CarlosCiconato/ecu-master/README.md

# ECU placa: hardware da injeção programável (base rusEFI)

> **Procurando o programa de ajuste (Mac/Windows)?** Ele fica em [CarlosCiconato/ecu-app](https://github.com/CarlosCiconato/ecu-app), com os instaladores em [Releases](https://github.com/CarlosCiconato/ecu-app/releases). Aqui fica só a placa.

Placa da ECU: placa KiCad, caixa 3D, firmware da placa e manuais.

| Pasta | O que tem |
|---|---|
| [`01-Firmware-rusEFI`](01-Firmware-rusEFI) | Configuração da placa no rusEFI e os patches de todas as melhorias |
| [`02-Placas-PCB`](02-Placas-PCB) | Placa top 6c completa (KiCad): esquema, placa e caixa 3D |
| [`03-Manuais-e-notas`](03-Manuais-e-notas) | Notas da placa, resumo das funções e como continuar o projeto |
| Programa | Está no repositório [ecu-app](https://github.com/CarlosCiconato/ecu-app) |

## Firmware

- Base: rusEFI oficial, commit `1b0196058f6`, com as nossas melhorias em patches.
- Código do rusEFI: baixe em **https://github.com/rusefi/rusefi** e volte para o commit base:
  ```bash
  git clone https://github.com/rusefi/rusefi.git
  cd rusefi
  git checkout 1b0196058f6
  # depois aplique os patches de 01-Firmware-rusEFI/patches com git am, na ordem dos itens
  ```
  A ordem dos itens e os detalhes estão em `03-Manuais-e-notas/CONTINUAR.md`.
- Resumo da placa: [`placa-top6c-firmware.md`](01-Firmware-rusEFI/placa-top6c-firmware.md).

## Continuar o projeto

Veja [`03-Manuais-e-notas/CONTINUAR.md`](03-Manuais-e-notas/CONTINUAR.md) e [`LEIA-ME.md`](LEIA-ME.md).
