CarlosCiconato/ecu-master/02-Placas-PCB/top-6c-rascunho7/bom-jlc-top6c-r7.csv

Comment | Designator | Footprint | LCSC
Battery_Cell | BT1 | BatteryHolder_Keystone_1060_1x2032 | C238069
100n | C1,C10,C11,C12,C13,C14,C15,C16,C2,C2313,C2314,C2315,C2316,C2505,C2506,C2507,C2508,C2601,C2602,C2605,C2608,C2612,C2613,C2614,C2615,C2617,C2618,C2701,C2702,C2705,C2708,C2712,C2713,C2714,C2715,C2717,C2718,C3,C4,C5,C6,C7,C8,C9 | C_0402_1005Metric | C1525
1u | C1002,C1015,C1016,C1017,C1018,C1212,C1523,C2001,C2101 | C_0603_1608Metric | C15849
10u | C1004,C1201,C2010,C2110,C27,C906 | C_1206_3216Metric | C13585
4.7u | C1006,C1502,C1506,C1507,C1512,C1515,C2616,C2716,C30,C903 | C_0603_1608Metric | C19666
100n | C1101,C1211,C1409,C1501,C1503,C1504,C1505,C1508,C1509,C1510,C1511,C1513,C1516,C1517,C1520,C1604,C1607,C1701,C1704,C20,C2301,C2309,C2501,C701,C801,C901,C904 | C_0603_1608Metric | C14663
10n | C1202,C1203,C1301,C1302,C1303,C1304,C1605,C1606,C1608,C1609,C1702,C1703,C1705,C1706,C1903,C28,C29,C902 | C_0603_1608Metric | C57112
1n | C1204,C1205,C1207,C1208,C1209,C1210,C1401,C1402,C1403,C1404,C1405,C1406,C1407,C1408,C3101 | C_0603_1608Metric | C1588
2.2u | C1518,C1519 | C_0603_1608Metric | C23630
33p | C1521,C1522 | C_0402_1005Metric | C1562
3.3n | C1901,C1902 | C_0805_2012Metric | C53175
22u | C2006,C2106 | C_0805_2012Metric | C45783
680p | C21,C22 | C_0603_1608Metric | C1630
330p | C23,C24,C905 | C_0402_1005Metric | C13533
47p | C25,C26 | C_0402_1005Metric | C1567
1u | C2600,C2607,C2609,C2610,C2611,C2700,C2707,C2709,C2710,C2711 | C_0402_1005Metric | C52923
33n | C2603,C2703 | C_0402_1005Metric | C1585
1uF | C3601,C4004 | C_0603_1608Metric | C15849
10nF | C3602 | C_0603_1608Metric | C57112
470pF | C3603 | C_0603_1608Metric | C1620
100nF | C3604,C4003,C4007,C4008,C4009 | C_0603_1608Metric | C14663
10uF | C4001 | C_0805_2012Metric | C15850
22uF | C4002 | C_0805_2012Metric | C45783
18pF | C4005,C4006 | C_0603_1608Metric | C1647
PESD1CAN-UX | D1,D2 | SOT-323_SC-70 | C152727
SM15T33CA | D1001 | D_SMC | C151281
D_Schottky | D101,D102,D103,D104,D901,D903 | D_SMA | C8678
SRV05-4 | D1501,U1,U1106,U1107,U2,U2304,U2502,U3,U4 | SOT-23-6 | C85364
schottky | D1503,D3,D4 | D_SOD-123 | C8598
D_Schottky | D2002,D2102 | D_SMA | C22452
LED-RED-0603 | D2600,D2603,D2700,D2703 | LED_0603_1608Metric | C2286
LED-GREEN-0603 | D2601,D2701 | LED_0603_1608Metric | C72043
LED-BLUE-0603 | D2602,D2702 | LED_0603_1608Metric | C72041
PESD1CAN | D2604,D2704 | SOT-23 | C343993
Polyfuse | F101,F102 | R_1206_3216Metric | C207035
Ferrite_Bead | FB1501 | L_0805_2012Metric | C1015
Micro_SD_Card | J1 | microSD_HC_Wuerth_693072010801 | C164170
USB-C HRO TYPE-C-31-M-12 | J3701 | USB_C_Receptacle_HRO_TYPE-C-31-M-12 | C165948
10u | L1001 | MWSA0503 | C408412
2.2u | L1002 | L_1210_3225Metric | C3222669
VNN7NV04PTR-E | Q2600,Q2700 | SOT-223 | C501115
AO3401A | Q3001,Q3011,Q3021 | SOT-23 | C15127
2N7002 | Q3002,Q3012,Q3022 | SOT-23 | C8545
5.6k | R1,R10,R11,R12,R17,R18,R19,R2,R20,R2325,R2326,R2327,R2328,R25,R2509,R2510,R2511,R2512,R26,R27,R28,R3,R4,R9 | R_0402_1005Metric | C25908
10k | R1001,R1006,R1007,R1105,R1107,R1109,R1111,R13,R14,R15,R1502,R1504,R1513,R16,R21,R22,R23,R2329,R2330,R2331,R2332,R24,R2513,R2514,R2515,R2516,R2604,R2605,R2613,R2614,R2618,R2619,R2625,R2704,R2705,R2713,R2714,R2718,R2719,R2725,R29,R30,R31,R32,R48,R5,R6,R7,R8,R905 | R_0402_1005Metric | C25744
120 | R1004,R1106,R1108,R1110,R1112,R33 | R_0603_1608Metric | C22787
2.7k | R1101,R1102,R1103,R1104,R1201,R1202,R1203,R1204,R1401,R1402,R1403,R1404,R1405,R1406,R1407,R1408,R2301,R2302,R2303,R2304 | R_0603_1608Metric | C13167
4.7k | R1205,R1206,R1208,R1209,R1210,R1211,R1213,R1214,R1215,R1216,R3101,R3102,R3103,R3104,R3106,R34,R35,R36,R37 | R_0805_2012Metric | C17673
1k | R1217,R1218,R2600,R2601,R2616,R2617,R2622,R2626,R2627,R2628,R2700,R2701,R2716,R2717,R2722,R2726,R2727,R2728,R39,R41 | R_0402_1005Metric | C11702
100k | R1501,R1901,R1902,R2615,R2621,R2715,R2721,R44,R45 | R_0402_1005Metric | C25741
82k | R1503 | R_0603_1608Metric | C23254
100 | R1601,R1602,R1603,R1604,R1701,R1702,R1703,R1704 | R_0805_2012Metric | C17408
470k | R1903,R1904,R2501,R2502,R2503,R2504,R701,R702,R703,R704,R801,R802,R803,R804,R901,R902,R903,R904 | R_0402_1005Metric | C25790
68k | R2602,R2603,R2702,R2703,R908 | R_0402_1005Metric | C36871
10 | R2606,R2706 | R_0402_1005Metric | C25077
22k | R2607,R2707 | R_0402_1005Metric | C25768
47 | R2608,R2708 | R_0402_1005Metric | C25118
61.9 | R2609,R2709 | R_0603_1608Metric | C23092
20k | R2610,R2611,R2612,R2710,R2711,R2712 | R_0402_1005Metric | C25765
27k | R2620,R2623,R2720,R2723 | R_0402_1005Metric | C25771
3.3k | R2624,R2724 | R_0402_1005Metric | C25890
10k | R3001,R3011,R3021 | R_0805_2012Metric | C17414
1k | R3002,R3012,R3022,R3601 | R_0805_2012Metric | C17513
100k | R3003,R3013,R3023 | R_0805_2012Metric | C149504
5.1k | R3701,R3702 | R_0603_1608Metric | C23186
33k | R38,R40,R46,R47 | R_0402_1005Metric | C25779
10k | R4001,R4002 | R_0603_1608Metric | C25804
470 | R4003,R4004 | R_0603_1608Metric | C23179
0 | R4005,R4006 | R_0603_1608Metric | C21189
12k | R42,R43,R907 | R_0402_1005Metric | C25752
1 | R906 | R_0402_1005Metric | C25086
10k | RN1101,RN1301,RN2301,RN2501,RN701,RN801,RN901 | R_Array_Convex_4x0603 | C29718
1k | RN1601,RN1701,RN201,RN202,RN2201,RN2202,RN301,RN302,RN401,RN402,RN501,RN502 | R_Array_Convex_4x0603 | C20197
SW_Push | SW1501,SW1502 | SW_SPST_EVQQ2 | C6039444
TLE9201SG | U10,U11 | Infineon_PG-DSO-12-9 | C112633
TLS115 | U1004,U1005 | Infineon_PG-DSO-8-43 | C3747428
MCP6004 | U1101,U2301,U2501,U2600,U2700,U5,U701,U801,U901 | TSSOP-14_4.4x5mm_P0.65mm | C50282
BTS4175SGA | U1102,U1103,U1104,U1105 | SOIC-8_3.9x4.9mm_P1.27mm | C152451
SN74LVC2G17DB | U1202,U1207,U1208 | SOT-23-6 | C10429
MAX9924 | U1203,U1204,U3101 | MSOP-10_3x3mm_P0.5mm | C143633
STM32F767IITx | U1501 | LQFP-176_24x24mm_P0.5mm | C90234
USBLC6-2SC6 | U1502 | SOT-23-6 | C7519
MIC4427 | U1602,U1603,U1701,U1702 | SOIC-8_3.9x4.9mm_P1.27mm | C20551
VNLD5160 | U201,U202,U2201,U2202,U301,U302,U401,U402,U501,U502 | SOIC-8_3.9x4.9mm_P1.27mm | C377942
AD8628 | U2601,U2701 | TSOT-23-5 | C29309
STM32F042K6Tx | U2602,U2702 | LQFP-32_7x7mm_P0.8mm | C69216
REF3033 | U2603,U2703 | SOT-23 | C36658
XC6206P332MR | U2604,U2704 | SOT-23 | C5446
TJA1051T/3/1J | U2605,U2705 | SO-8_3.9x4.9mm_P1.27mm | C38695
ESP32-S3-WROOM-1U-N8 | U4001 | ESP32-S3-WROOM-1U | C2980297
AMS1117-3.3 | U4002,U902 | SOT-223-3_TabPin2 | C6186
TJA1051T-3 | U6,U904 | SOIC-8_3.9x4.9mm_P1.27mm | C38695
MCP6002-xSN | U7 | SOIC-8_3.9x4.9mm_P1.27mm | C7377
REF3333 | U8 | SOT-23 | C130016
LPS25HB | U9 | ST_HLGA-10_2.5x2.5mm_P0.6mm_LayoutBorder3x2y | C87898
LMR14020 | U903 | SOIC-8-1EP_3.9x4.9mm_P1.27mm_EP2.29x3mm | C187824
8MHz | Y1501 | Crystal_SMD_5032-2Pin_5.0x3.2mm | C115962
32.768kHz 12.5pF | Y4001 | Crystal_SMD_3215-2Pin_3.2x1.5mm | C32346
