CarlosCiconato/ecu-master/02-Placas-PCB/caixa-3d-placa-top6c/placa-fantasma.stl

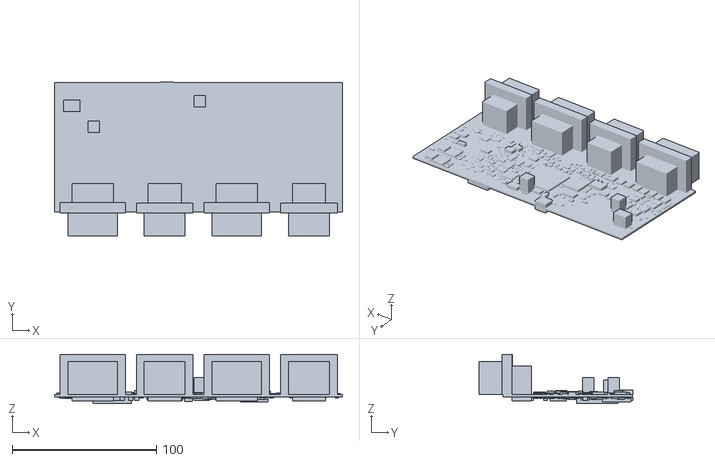
[picture p1: CAD file, 2026-11-10]
02-Placas-PCB/caixa-3d-placa-top6c/placa-fantasma.stl
200.0 x 106.8 x 34.1
