CarlosCiconato/ecu-master/02-Placas-PCB/caixa-3d-placa-top6c/base.stl

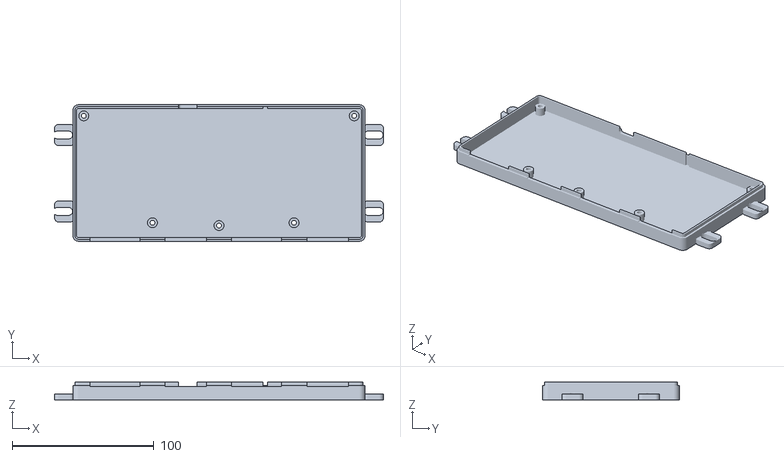
[picture p2: CAD file, 2026-11-10]
02-Placas-PCB/caixa-3d-placa-top6c/base.stl
232.4 x 96.5 x 12.5
