CarlosCiconato/ecu-master/02-Placas-PCB/caixa-3d-placa-top6c/v1-reta/tampa.stl

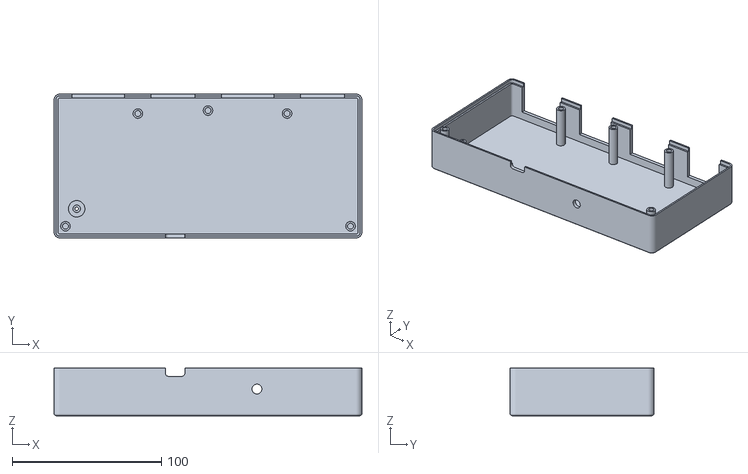
[picture p3: CAD file, 2026-11-10]
02-Placas-PCB/caixa-3d-placa-top6c/v1-reta/tampa.stl
206.4 x 96.5 x 31.9
