CarlosCiconato/ecu-master/02-Placas-PCB/caixa-3d-placa-top6c/caixa.step

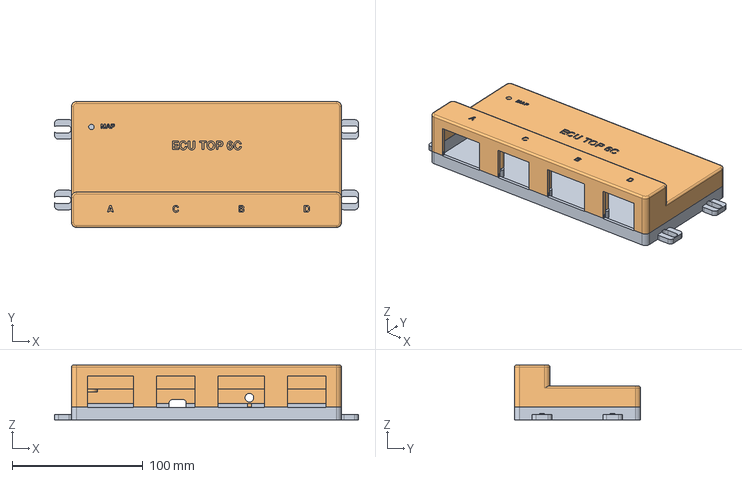
[picture p4: CAD file, 2026-11-10]
02-Placas-PCB/caixa-3d-placa-top6c/caixa.step
232.4 x 96.5 x 41.9 mm
base
tampa
