CarlosCiconato/ecu-master/02-Placas-PCB/caixa-3d-placa-top6c/v1-reta/caixa.step

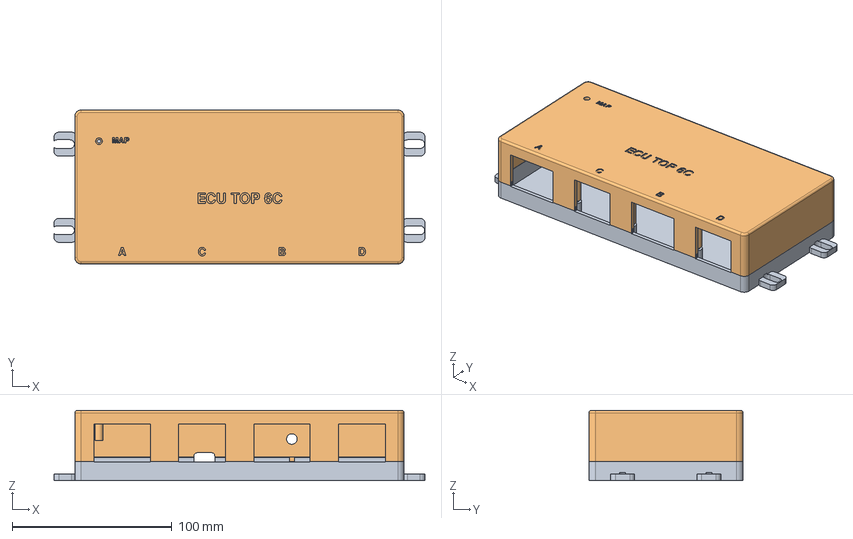
[picture p5: CAD file, 2026-11-10]
02-Placas-PCB/caixa-3d-placa-top6c/v1-reta/caixa.step
232.4 x 96.5 x 43.9 mm
base
tampa
