CarlosCiconato/ecu-master/02-Placas-PCB/caixa-3d-placa-top6c/v1-reta/base.stl

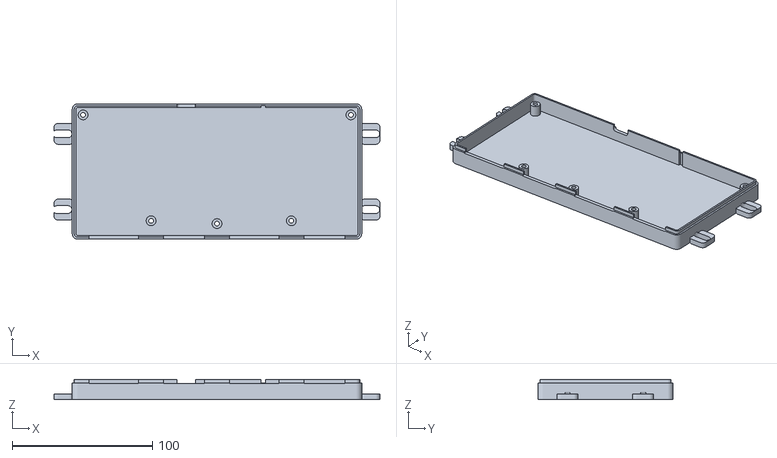
[picture p6: CAD file, 2026-11-10]
02-Placas-PCB/caixa-3d-placa-top6c/v1-reta/base.stl
232.4 x 96.5 x 14.5
