CarlosCiconato/ecu-master/02-Placas-PCB/caixa-3d-placa-top6c/tampa.stl

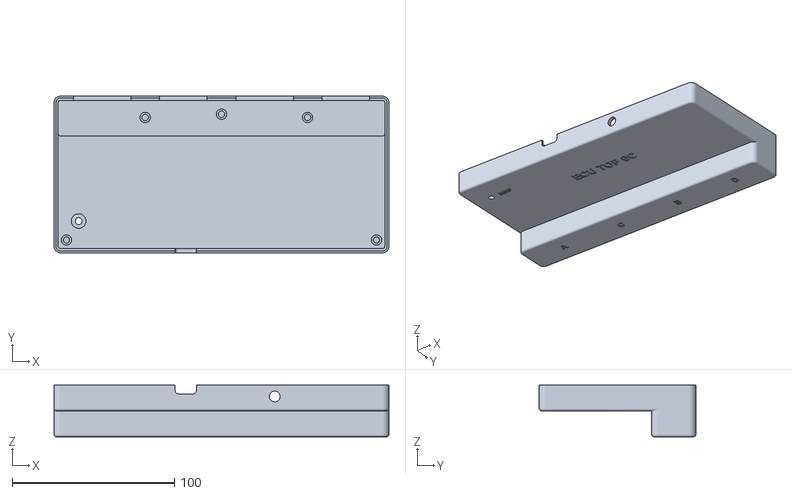
[picture p7: CAD file, 2026-11-10]
02-Placas-PCB/caixa-3d-placa-top6c/tampa.stl
206.4 x 96.5 x 31.9
