CarlosCiconato/ecu-master/02-Placas-PCB/top-6c-esquema-kicad/proteus.kicad_pcb

## KiCad design 02-Placas-PCB/top-6c-esquema-kicad/proteus.kicad_pcb (2026-11-10)

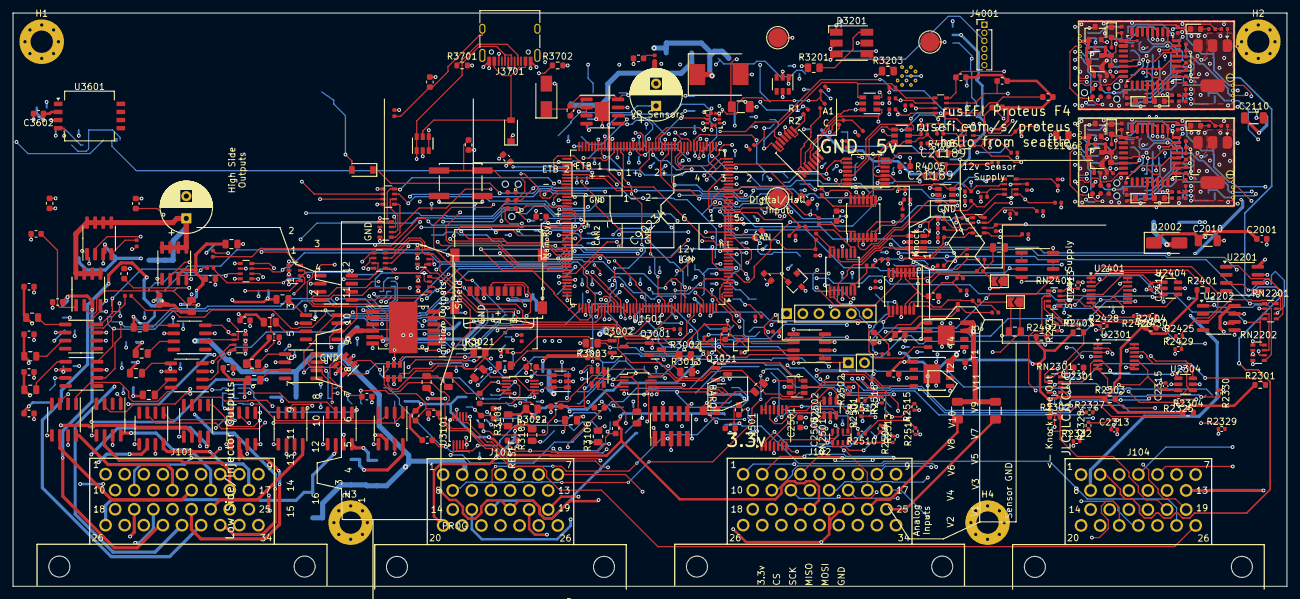
[picture p8: board proteus.kicad_pcb from above]

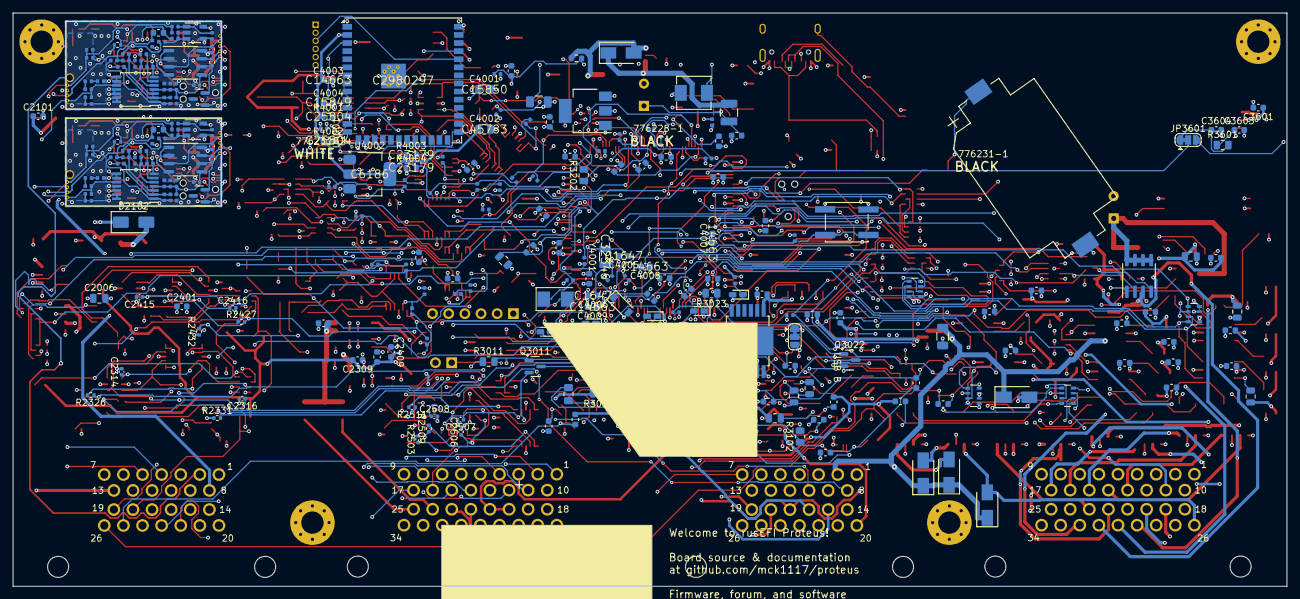
[picture p9: board proteus.kicad_pcb from below]

Board: 6 copper layers, 200.0 x 90.0 mm, 613 parts (252 on the bottom side), 481 nets.

Parts:
BT1: Battery_Cell; BatteryHolder_Keystone_1060_1x2032
C1, C2, C3, C4, C5, C6, C7, C8, C9, C10, C11, C12, C13, C14, C15, C16, C2313, C2314, C2315, C2316, C2413, C2414, C2415, C2416, C2505, C2506, C2507, C2508, C2601, C2602, C2605, C2608, C2612, C2613, C2614, C2615, C2617, C2618, C2701, C2702, C2705, C2708, C2712, C2713, C2714, C2715, C2717, C2718: 100n; C_0402_1005Metric
C17, C1001: 56u; CP_Radial_D8.0mm_P3.50mm
C20, C701, C801, C901, C904, C1101, C1211, C1409, C1501, C1503, C1504, C1505, C1508, C1509, C1510, C1511, C1513, C1516, C1517, C1520, C1604, C1607, C1701, C1704, C1801, C1804, C2301, C2309, C2401, C2409, C2501: 100n; C_0603_1608Metric
C21, C22: 680p; C_0603_1608Metric
C23, C24, C905: 330p; C_0402_1005Metric
C25, C26: 47p; C_0402_1005Metric
C27, C906, C1004, C1201, C2010, C2110: 10u; C_1206_3216Metric
C28, C29, C902, C1202, C1203, C1301, C1302, C1303, C1304, C1605, C1606, C1608, C1609, C1702, C1703, C1705, C1706, C1802, C1803, C1805, C1806, C1903: 10n; C_0603_1608Metric
C30, C903, C1006, C1502, C1506, C1507, C1512, C1515, C2616, C2716: 4.7u; C_0603_1608Metric
C1002, C1015, C1016, C1017, C1018, C1212, C1523, C2001, C2101: 1u; C_0603_1608Metric
C1204, C1205, C1207, C1208, C1209, C1210, C1401, C1402, C1403, C1404, C1405, C1406, C1407, C1408, C3101: 1n; C_0603_1608Metric
C1518, C1519: 2.2u; C_0603_1608Metric
C1521, C1522: 33p; C_0402_1005Metric
C1901, C1902: 3.3n; C_0805_2012Metric
C2006, C2106: 22u; C_0805_2012Metric
C2600, C2607, C2609, C2610, C2611, C2700, C2707, C2709, C2710, C2711: 1u; C_0402_1005Metric
C2603, C2703: 33n; C_0402_1005Metric
C2604, C2606, C2704, C2706: DNP; C_0402_1005Metric
C3601, C4004: 1uF; C_0603_1608Metric
C3602: 10nF; C_0603_1608Metric
C3603: 470pF; C_0603_1608Metric
C3604, C4003, C4007, C4008, C4009: 100nF; C_0603_1608Metric
C4001: 10uF; C_0805_2012Metric
C4002: 22uF; C_0805_2012Metric
C4005, C4006: 18pF; C_0603_1608Metric
D1, D2: PESD1CAN-UX; SOT-323_SC-70
D3, D4, D1503: schottky; D_SOD-123
D101, D102, D103, D104, D901, D903, D2002, D2102: D_Schottky; D_SMA
D1001: SM15T33CA; D_SMC
D1501: SRV05-4; SOT-23-6
D1502, D1506: GREEN; LED_0603_1608Metric_Castellated
D1504: RED; LED_0603_1608Metric_Castellated
D1505: BLUE; LED_0603_1608Metric_Castellated
D1507: ORANGE; LED_0603_1608Metric_Castellated
D2600, D2603, D2700, D2703: LED-RED-0603; LED_0603_1608Metric
D2601, D2701: LED-GREEN-0603; LED_0603_1608Metric
D2602, D2702: LED-BLUE-0603; LED_0603_1608Metric
D2604, D2704: PESD1CAN; SOT-23
D3201: LED RGB; LED_RGB_5050-6
F101, F102: Polyfuse; R_1206_3216Metric
FB1501: Ferrite_Bead; L_0805_2012Metric
H1, H2, H3, H4: MountingHole_3.5mm_Pad_Via
J1: Micro_SD_Card; microSD_HC_Wuerth_693072010801
J2: Conn_01x02; PinHeader_1x02_P2.54mm_Vertical
J4: Conn_01x06; Tag-Connect_TC2030-IDC-NL_2x03_P1.27mm_Vertical
J101: Superseal 1.0 34p · A motor (34); 6437288-2
J102: Superseal 1.0 34p · B sensores (34); 6437288-2
J103: Superseal 1.0 26p · C carro (26); 6473423-1
J104: Superseal 1.0 26p · D sondas/extras (26); 6473423-1
J105, J107, J108: Conn_01x01; TestPoint_Pad_D3.0mm
J1502: Conn_02x05_Odd_Even; PinHeader_2x05_P1.27mm_Vertical_SMD
J1505: Conn_01x06; PinHeader_1x06_P2.54mm_Vertical
J2600, J2700: Conn_02x03_Odd_Even; Tag-Connect_TC2030-IDC-NL_2x03_P1.27mm_Vertical
J3701: USB-C HRO TYPE-C-31-M-12; USB_C_Receptacle_HRO_TYPE-C-31-M-12
J4001: PROG_ESP32; PinHeader_1x06_P1.27mm_Vertical
JP1, JP2: Jumper_NO_Small; SolderJumper-2_P1.3mm_Open_TrianglePad1.0x1.5mm
JP1201: Jumper_3_Bridged12; SolderJumper-3_P1.3mm_Bridged12_RoundedPad1.0x1.5mm
JP3601: MAP int(1-2)/ext(2-3); SolderJumper-3_P1.3mm_Bridged12_RoundedPad1.0x1.5mm
L1001: 10u; MWSA0503
L1002: 2.2u; L_1210_3225Metric
M1, M2: Module-wbo-0.6; wbo
Q2600, Q2700: VNN7NV04PTR-E; SOT-223
Q3001, Q3011, Q3021: AO3401A; SOT-23
Q3002, Q3012, Q3022: 2N7002; SOT-23
R1, R2, R3, R4, R9, R10, R11, R12, R17, R18, R19, R20, R25, R26, R27, R28, R2325, R2326, R2327, R2328, R2425, R2426, R2427, R2428, R2509, R2510, R2511, R2512: 5.6k; R_0402_1005Metric
R5, R6, R7, R8, R13, R14, R15, R16, R21, R22, R23, R24, R29, R30, R31, R32, R48, R905, R1001, R1006, R1007, R1105, R1107, R1109, R1111, R1502, R1504, R1513, R2329, R2330, R2331, R2332, R2429, R2430, R2431, R2432, R2513, R2514, R2515, R2516, R2604, R2605, R2613, R2614, R2618, R2619, R2625, R2704, R2705, R2713, R2714, R2718, R2719, R2725: 10k; R_0402_1005Metric
R33, R1004, R1106, R1108, R1110, R1112: 120; R_0603_1608Metric
R34, R35, R36, R37, R1205, R1206, R1208, R1209, R1210, R1211, R1213, R1214, R1215, R1216, R3101, R3102, R3103, R3104, R3106: 4.7k; R_0805_2012Metric
R38, R40, R46, R47: 33k; R_0402_1005Metric
R39, R41, R1217, R1218, R2600, R2601, R2616, R2617, R2622, R2626, R2627, R2628, R2700, R2701, R2716, R2717, R2722, R2726, R2727, R2728: 1k; R_0402_1005Metric
R42, R43, R907: 12k; R_0402_1005Metric
R44, R45, R1501, R1901, R1902, R2615, R2621, R2715, R2721: 100k; R_0402_1005Metric
R701, R702, R703, R704, R801, R802, R803, R804, R901, R902, R903, R904, R1903, R1904, R2501, R2502, R2503, R2504: 470k; R_0402_1005Metric
R906: 1; R_0402_1005Metric
R908, R2602, R2603, R2702, R2703: 68k; R_0402_1005Metric
R1101, R1102, R1103, R1104, R1201, R1202, R1203, R1204, R1401, R1402, R1403, R1404, R1405, R1406, R1407, R1408, R2301, R2302, R2303, R2304, R2401, R2402, R2403, R2404: 2.7k; R_0603_1608Metric
R1207, R1212, R3105: DNP; R_0805_2012Metric
R1219, R1220: DNP; R_0805_2012Metric_Pad1.15x1.40mm_HandSolder
R1503: 82k; R_0603_1608Metric
R1508, R1509, R1510, R1511, R1512: 330; R_0402_1005Metric
R1601, R1602, R1603, R1604, R1701, R1702, R1703, R1704, R1801, R1802, R1803, R1804: 100; R_0805_2012Metric
R2606, R2706: 10; R_0402_1005Metric
R2607, R2707: 22k; R_0402_1005Metric
R2608, R2708: 47; R_0402_1005Metric
R2609, R2709: 61.9; R_0603_1608Metric
R2610, R2611, R2612, R2710, R2711, R2712: 20k; R_0402_1005Metric
R2620, R2623, R2720, R2723: 27k; R_0402_1005Metric
R2624, R2724: 3.3k; R_0402_1005Metric
R2629, R2630, R2729, R2730: DNP; R_0402_1005Metric
R3001, R3011, R3021: 10k; R_0805_2012Metric
R3002, R3012, R3022, R3601: 1k; R_0805_2012Metric
R3003, R3013, R3023: 100k; R_0805_2012Metric
R3201, R3202, R3203: 330; R_0805_2012Metric
R3701, R3702: 5.1k; R_0603_1608Metric
R4001, R4002: 10k; R_0603_1608Metric
R4003, R4004: 470; R_0603_1608Metric
R4005, R4006: 0; R_0603_1608Metric
RN201, RN202, RN301, RN302, RN401, RN402, RN501, RN502, RN1601, RN1701, RN1801, RN2201, RN2202: 1k; R_Array_Convex_4x0603
RN701, RN801, RN901, RN1101, RN1301, RN2301, RN2401, RN2501: 10k; R_Array_Convex_4x0603
SW1501, SW1502: SW_Push; SW_SPST_EVQQ2
U1, U2, U3, U4, U1106, U1107, U2304, U2404, U2502: SRV05-4; SOT-23-6
U5, U701, U801, U901, U1101, U2301, U2401, U2501, U2600, U2700: MCP6004; TSSOP-14_4.4x5mm_P0.65mm
U6, U904: TJA1051T-3; SOIC-8_3.9x4.9mm_P1.27mm
U7: MCP6002-xSN; SOIC-8_3.9x4.9mm_P1.27mm
U8: REF3333; SOT-23
U9: LPS25HB; ST_HLGA-10_2.5x2.5mm_P0.6mm_LayoutBorder3x2y
U10, U11: TLE9201SG; Infineon_PG-DSO-12-9
U201, U202, U301, U302, U401, U402, U501, U502, U2201, U2202: VNLD5160; SOIC-8_3.9x4.9mm_P1.27mm
U902, U4002: AMS1117-3.3; SOT-223-3_TabPin2
U903: LMR14020; SOIC-8-1EP_3.9x4.9mm_P1.27mm_EP2.29x3mm
U1004, U1005: TLS115; Infineon_PG-DSO-8-43
U1102, U1103, U1104, U1105: BTS4175SGA; SOIC-8_3.9x4.9mm_P1.27mm
U1202, U1207, U1208: SN74LVC2G17DB; SOT-23-6
U1203, U1204, U3101: MAX9924; MSOP-10_3x3mm_P0.5mm
U1501: STM32F767IITx; LQFP-176_24x24mm_P0.5mm
U1502: USBLC6-2SC6; SOT-23-6
U1602, U1603, U1701, U1702, U1801, U1802: MIC4427; SOIC-8_3.9x4.9mm_P1.27mm
U2601, U2701: AD8628; TSOT-23-5
U2602, U2702: STM32F042K6Tx; LQFP-32_7x7mm_P0.8mm
U2603, U2703: REF3033; SOT-23
U2604, U2704: XC6206P332MR; SOT-23
U2605, U2705: TJA1051T/3/1J; SO-8_3.9x4.9mm_P1.27mm
U3601: MPXH6400A (4 bar abs); Freescale_98ARH99066A
U4001: ESP32-S3-WROOM-1U-N8; ESP32-S3-WROOM-1U
Y1501: 8MHz; Crystal_SMD_5032-2Pin_5.0x3.2mm
Y4001: 32.768kHz 12.5pF; Crystal_SMD_3215-2Pin_3.2x1.5mm

Connections:
+3V3: C20.1, C903.1, C1503.2, C1504.2, C1505.2, C1506.2, C1507.2, C1508.2, C1509.2, C1510.2, C1511.2, C1512.2, C1513.2, C1515.2, C4007.1, C4008.1, C4009.1, D4.2, D1501.5, D1502.2, FB1501.1, J1.4, J4.1, J108.1, J1502.1, J1505.1, R39.1, R40.2, R41.1, R48.2, R1001.2, R1006.2, R1007.2, R1105.2, R1107.2, R1109.2, R1111.2, R1215.1, R1216.1, R1502.2, R3106.1, SW1502.2, U5.4, U6.5, U9.1, U9.6, U9.10, U10.2, U11.2, U902.2, U904.5, U1501.15, U1501.23, U1501.36, U1501.49, U1501.62, U1501.72, U1501.82, U1501.91, U1501.103, U1501.114, U1501.127, U1501.136, U1501.149, U1501.159, U1501.171, U1501.172
+5V: C701.1, C801.1, C901.1, C905.1, C906.1, C1004.1, C1101.1, C1211.1, C1604.2, C1607.2, C1701.2, C1704.2, C1801.2, C1804.2, C2006.1, C2106.1, C2301.1, C2401.1, C2501.1, C2610.1, C2613.1, C2617.1, C2710.1, C2713.1, C2717.1, C4001.1, D1503.1, J107.1, JP1201.1, L1001.2, M1.W1 (V5_IN), M2.W1 (V5_IN), Q3001.2, Q3011.2, Q3021.2, R908.2, R1217.1, R3001.1, R3011.1, R3021.1, U1.5, U2.5, U3.5, U4.5, U6.3, U7.8, U8.1, U701.4, U801.4, U901.4, U902.3, U904.3, U1004.5, U1005.5, U1101.4, U1106.5, U1107.5, U1202.5, U1203.9, U1203.10, U1204.10, U1207.5, U1208.5, U1602.6, U1603.6, U1701.6, U1702.6, U1801.6, U1802.6, U2301.4, U2304.5, U2401.4, U2404.5, U2501.4, U2502.5, U2603.1 (IN), U2604.3 (VI), U2605.3 (VCC), U2703.1 (IN), U2704.3 (VI), U2705.3 (VCC), U3101.10, U4002.3
/5V_SENSOR_1: C1016.1, C1409.2, C2309.2, C2409.2, J102.20, J102.21, R1101.1, R1102.1, R1103.1, R1104.1, R1201.1, R1203.1, R1401.1, R1403.1, R1405.1, R1407.1, R2301.1, R2302.1, R2303.1, R2304.1, R2401.1, R2402.1, R2403.1, R2404.1, U1004.1
/5V_SENSOR_2: C1018.1, C3601.1, C3602.1, J102.22, J102.23, U1005.1, U3601.2
/12V_MR: C17.1, C27.2, C1201.2, D101.1, D102.1, D103.1, D104.1, D2002.2, D2102.2, J103.2, U10.4, U11.4, U1102.5, U1102.6, U1102.7, U1102.8, U1103.5, U1103.6, U1103.7, U1103.8, U1104.5, U1104.6, U1104.7, U1104.8, U1105.5, U1105.6, U1105.7, U1105.8
/12V_PROT: C1015.1, C1017.1, D903.1, F101.2, F102.1, L1002.1, R906.1, U1004.7, U1004.8, U1005.7, U1005.8
/12V_RAW: D903.2, D1001.1, J103.1, R1503.1
/12V_SENS_1: F101.1, J102.24
/12V_SENS_2: F102.2, J102.25
/AIN13_PIN: J102.16, R2501.1, RN2501.1
/AIN14_EXT: J102.17, JP3601.3
/AIN14_PIN: JP3601.2, R2502.1, RN2501.2
/AT1: J102.12, R1101.2, RN1101.1
/AT2: J102.13, R1102.2, RN1101.2
/AT3: J102.14, R1103.2, RN1101.3
/AT4: J102.15, R1104.2, RN1101.4
/AV1: J102.1, R701.1, RN701.1
/AV2: J102.2, R702.1, RN701.2
/AV3: J102.3, R703.1, RN701.3
/AV4: J102.4, R704.1, RN701.4
/AV5: J102.5, R801.1, RN801.1
/AV6: J102.6, R802.1, RN801.2
/AV7: J102.7, R803.1, RN801.3
/AV8: J102.8, R804.1, RN801.4
/AV9: J102.9, R901.1, RN901.1
/AV10: J102.10, R902.1, RN901.2
/AV11: J102.11, R903.1, RN901.3
/CAN2+: D2.2, J103.9, R33.1, U6.7
/CAN2-: D2.1, J103.10, R33.2, U6.6
/CAN+: D1.2, D2604.1 (G), D2704.1 (G), J103.7, M1.W4 (CANH), M2.W4 (CANH), R1004.1, R2629.2, R2729.2, U904.7, U2605.7 (CANH), U2705.7 (CANH)
/CAN-: D1.1, D2604.2 (D), D2704.2 (D), J103.8, M1.W3 (CANL), M2.W3 (CANL), R1004.2, R2629.1, R2729.1, U904.6, U2605.6 (CANL), U2705.6 (CANL)
/DIGITAL_1: C1401.1, J103.21, R1401.2, R1402.2
/DIGITAL_2: C1403.1, J103.22, R1403.2, R1404.2
/DIGITAL_3: C1405.1, J103.23, R1405.2, R1406.2
/DIGITAL_4: C1407.1, J103.24, R1407.2, R1408.2
/DIGITAL_5: C1204.1, J104.25, R1201.2, R1202.2
/DIGITAL_6: C1207.1, J104.26, R1203.2, R1204.2
/ETB1+: C1202.2, J103.11, U10.5
/ETB1-: C1203.1, J103.12, U10.7
/ETB2+: C28.2, J103.13, U11.5
/ETB2-: C29.1, J103.14, U11.7
/HS1: C1301.1, J101.29, R34.1, U1102.3
/HS2: C1302.1, J101.30, R35.1, U1103.3
/HS3: C1303.1, J101.31, R36.1, U1104.3
/HS4: C1304.1, J101.32, R37.1, U1105.3
/IGN1: C1605.1, J101.1, R1601.1
/IGN2: C1606.1, J101.2, R1602.1
/IGN3: C1608.1, J101.3, R1603.1
/IGN4: C1609.1, J101.4, R1604.1
/IGN5: C1702.1, J101.5, R1701.1
/IGN6: C1703.1, J101.6, R1702.1
/IGN7: C1705.1, J101.7, R1703.1
/IGN8: C1706.1, J101.8, R1704.1
/IGN9: C1802.1, J101.9, R1801.1
/IGN10: C1803.1, J101.10, R1802.1
/IGN11: C1805.1, J101.11, R1803.1
/IGN12: C1806.1, J101.12, R1804.1
/KNOCK_1: C1901.2, J102.18, JP1.1
/KNOCK_2: C1902.2, J102.19, JP2.1
/LS1: J101.13, U201.8
/LS2: J101.14, U201.6
/LS3: J101.15, U202.8
/LS4: J101.16, U202.6
/LS5: J101.17, U301.8
/LS6: J101.18, U301.6
/LS7: J101.19, U302.8
/LS8: J101.20, U302.6
/LS9: J101.21, U401.8
/LS10: J101.22, U401.6
/LS11: J101.23, U402.8
/LS12: J101.24, U402.6
/LS13: D103.2, J101.25, U501.8
/LS14: D101.2, J101.26, U501.6
/LS15: D104.2, J101.27, U502.8
/LS16: D102.2, J101.28, U502.6
/LS17: J104.13, U2201.8
/LS18: J104.14, U2201.6
/LS19: J104.15, U2202.8
/LS20: J104.16, U2202.6
/SW1_PIN: J104.17, R2301.2, RN2301.1
/SW2_PIN: J104.18, R2302.2, RN2301.2
/SW3_PIN: J104.19, R2303.2, RN2301.3
/SW4_PIN: J104.20, R2304.2, RN2301.4
/SW5_PIN: J104.21, R2401.2, RN2401.1
/SW6_PIN: J104.22, R2402.2, RN2401.2
/SW7_PIN: J104.23, R2403.2, RN2401.3
/SW8_PIN: J104.24, R2404.2, RN2401.4
/VR1+: J103.15, R1205.2, R3002.2
/VR1-: J103.16, R1208.2
/VR2+: J103.17, R1210.2, R3012.2
/VR2-: J103.18, R1213.2
/VR3+: J103.19, R3022.2, R3101.2
/VR3-: J103.20, R3103.2
/WB1_HEATER+: C2001.1, C2010.1, D2002.1, J104.3
/WB1_HEATER-: J104.2, M1.E5 (LSU_Htr), Q2600.2 (D), Q2600.4 (D)
/WB1_IP: J104.1, M1.E3 (LSU_Ip), R2609.2, R2614.2
/WB1_RTRIM: J104.5, M1.E4 (LSU_Rtrim), R2605.1, R2608.1, R2609.1, R2613.2
/WB1_UN: C2605.1, J104.6, M1.E1 (LSU_Un), R2612.1, U2600.10 (+)
/WB1_VM: C2607.1, J104.4, M1.E2 (LSU_Vm), R2606.1, R2618.1, U2602.7 (PA1)
/WB2_HEATER+: C2101.1, C2110.1, D2102.1, J104.9
/WB2_HEATER-: J104.8, M2.E5 (LSU_Htr), Q2700.2 (D), Q2700.4 (D)
/WB2_IP: J104.7, M2.E3 (LSU_Ip), R2709.2, R2714.2
/WB2_RTRIM: J104.11, M2.E4 (LSU_Rtrim), R2705.1, R2708.1, R2709.1, R2713.2
/WB2_UN: C2705.1, J104.12, M2.E1 (LSU_Un), R2712.1, U2700.10 (+)
/WB2_VM: C2707.1, J104.10, M2.E2 (LSU_Vm), R2706.1, R2718.1, U2702.7 (PA1)
/WBO1/+3V3: C2601.1, C2602.1, C2604.1, C2606.1, C2614.1, C2615.1, C2616.1, C2618.1, J2600.1, M1.J_VCC1 (PULL_UP1), M1.J_VCC2 (PULL_UP2), M1.W2 (CAN_VIO), M1.W8 (V33_OUT), R2610.2, R2628.2, U2600.4 (V+), U2601.5 (V+), U2602.1 (VDD), U2602.17 (VDDIO2), U2604.2 (VO), U2605.5 (VIO)
/WBO1/Boot0: R2625.2, U2602.31 (PB8)
/WBO1/CAN_RX: U2602.21 (PA11), U2605.4 (RXD)
/WBO1/CAN_TX: U2602.22 (PA12), U2605.1 (TXD)
/WBO1/Ip_dac: R2602.1, U2602.12 (PA6)
/WBO1/Ip_sense: C2608.1, R2624.2, U2602.8 (PA2)
/WBO1/LED_BLUE: D2602.2 (A), U2602.28 (PB5)
/WBO1/LED_GREEN: D2601.2 (A), U2602.29 (PB6)
/WBO1/LSU_Un_sense: R2619.1, U2600.8, U2600.9 (-)
/WBO1/Nernst_esr_drive: R2607.2, U2602.30 (PB7)
/WBO1/Net-(C603-Pad1): C2603.1, R2604.1, R2608.2, U2600.1
/WBO1/Net-(C605-Pad2): C2605.2, R2607.1
/WBO1/Net-(D600-A): D2600.2 (A), R2616.1
/WBO1/Net-(D601-K): D2601.1 (K), R2626.2
/WBO1/Net-(D602-K): D2602.1 (K), R2627.2
/WBO1/Net-(D603-A): D2603.2 (A), R2628.1
/WBO1/Net-(M1-VDDA): M1.W9 (VDDA), R2630.2
/WBO1/Net-(Q600-G): Q2600.1 (G), R2622.1
/WBO1/Net-(R610-Pad1): R2610.1, R2611.2
/WBO1/Net-(R611-Pad1): R2611.1, R2612.2
/WBO1/Net-(R621-Pad1): R2621.1, R2624.1, U2601.1
/WBO1/Net-(U600A-+): R2603.1, R2605.2, U2600.3 (+)
/WBO1/Net-(U600A--): C2603.2, R2602.2, R2604.2, U2600.2 (-)
/WBO1/Net-(U600B-+): R2619.2, R2620.1, U2600.5 (+)
/WBO1/Net-(U600B--): R2618.2, R2623.1, U2600.6 (-)
/WBO1/Net-(U600D-+): C2600.1, R2600.2, R2601.1, U2600.12 (+)
/WBO1/Net-(U601-+): R2614.1, R2615.1, U2601.3 (+)
/WBO1/Net-(U601--): R2613.1, R2621.2, U2601.4 (-)
/WBO1/SEL1: M1.J1 (SEL1), U2602.15 (PB1)
/WBO1/SEL2: M1.J2 (SEL2), U2602.18 (PA8)
/WBO1/SWCLK: J2600.4, M1.W7 (SWCLK), U2602.24 (PA14)
/WBO1/SWDIO: J2600.2, M1.W6 (SWDIO), U2602.23 (PA13)
/WBO1/Un_sense: R2623.2, U2600.7, U2602.6 (PA0)
/WBO1/VDDA: C2611.1, C2612.1, R2600.1, R2630.1, U2602.5 (VDDA), U2603.2 (OUT)
/WBO1/Vm: R2603.2, R2606.2, R2615.2, U2600.13 (-), U2600.14, U2602.9 (PA3)
/WBO1/heater_pwm: R2616.2, R2617.2, R2622.2, U2602.13 (PA7)
/WBO1/nRESET: C2609.1, J2600.3, M1.W5 (nReset), U2602.4 (NRST)
/WBO2/+3V3: C2701.1, C2702.1, C2704.1, C2706.1, C2714.1, C2715.1, C2716.1, C2718.1, J2700.1, M2.J_VCC1 (PULL_UP1), M2.J_VCC2 (PULL_UP2), M2.W2 (CAN_VIO), M2.W8 (V33_OUT), R2710.2, R2728.2, U2700.4 (V+), U2701.5 (V+), U2702.1 (VDD), U2702.17 (VDDIO2), U2704.2 (VO), U2705.5 (VIO)
/WBO2/Boot0: R2725.2, U2702.31 (PB8)
/WBO2/CAN_RX: U2702.21 (PA11), U2705.4 (RXD)
/WBO2/CAN_TX: U2702.22 (PA12), U2705.1 (TXD)
/WBO2/Ip_dac: R2702.1, U2702.12 (PA6)
/WBO2/Ip_sense: C2708.1, R2724.2, U2702.8 (PA2)
/WBO2/LED_BLUE: D2702.2 (A), U2702.28 (PB5)
/WBO2/LED_GREEN: D2701.2 (A), U2702.29 (PB6)
/WBO2/LSU_Un_sense: R2719.1, U2700.8, U2700.9 (-)
/WBO2/Nernst_esr_drive: R2707.2, U2702.30 (PB7)
/WBO2/Net-(C603-Pad1): C2703.1, R2704.1, R2708.2, U2700.1
/WBO2/Net-(C605-Pad2): C2705.2, R2707.1
/WBO2/Net-(D600-A): D2700.2 (A), R2716.1
/WBO2/Net-(D601-K): D2701.1 (K), R2726.2
/WBO2/Net-(D602-K): D2702.1 (K), R2727.2
/WBO2/Net-(D603-A): D2703.2 (A), R2728.1
/WBO2/Net-(M1-VDDA): M2.W9 (VDDA), R2730.2
/WBO2/Net-(Q600-G): Q2700.1 (G), R2722.1
/WBO2/Net-(R610-Pad1): R2710.1, R2711.2
/WBO2/Net-(R611-Pad1): R2711.1, R2712.2
/WBO2/Net-(R621-Pad1): R2721.1, R2724.1, U2701.1
/WBO2/Net-(U600A-+): R2703.1, R2705.2, U2700.3 (+)
/WBO2/Net-(U600A--): C2703.2, R2702.2, R2704.2, U2700.2 (-)
/WBO2/Net-(U600B-+): R2719.2, R2720.1, U2700.5 (+)
/WBO2/Net-(U600B--): R2718.2, R2723.1, U2700.6 (-)
/WBO2/Net-(U600D-+): C2700.1, R2700.2, R2701.1, U2700.12 (+)
/WBO2/Net-(U601-+): R2714.1, R2715.1, U2701.3 (+)
/WBO2/Net-(U601--): R2713.1, R2721.2, U2701.4 (-)
/WBO2/SEL1: M2.J1 (SEL1), U2702.15 (PB1)
/WBO2/SEL2: M2.J2 (SEL2), U2702.18 (PA8)
/WBO2/SWCLK: J2700.4, M2.W7 (SWCLK), U2702.24 (PA14)
/WBO2/SWDIO: J2700.2, M2.W6 (SWDIO), U2702.23 (PA13)
/WBO2/Un_sense: R2723.2, U2700.7, U2702.6 (PA0)
/WBO2/VDDA: C2711.1, C2712.1, R2700.1, R2730.1, U2702.5 (VDDA), U2703.2 (OUT)
/WBO2/Vm: R2703.2, R2706.2, R2715.2, U2700.13 (-), U2700.14, U2702.9 (PA3)
/WBO2/heater_pwm: R2716.2, R2717.2, R2722.2, U2702.13 (PA7)
/WBO2/nRESET: C2709.1, J2700.3, M2.W5 (nReset), U2702.4 (NRST)
/analog5/IN3: R2503.1, RN2501.3
/analog5/IN4: R2504.1, RN2501.4
/analog5/OUT3: R2511.1, R2515.2
/analog5/OUT4: R2512.1, R2516.2
/knock/FILTERED_1: C23.2, U5.6, U5.7, U7.3, U1501.20
/knock/FILTERED_2: C24.2, U5.8, U5.9, U7.5, U1501.21
/knock/V_mid: C1903.2, R38.1, R40.1, U5.3, U5.12
/led_status/BA: D3201.4, R3203.2
/led_status/GA: D3201.5, R3202.2
/led_status/RA: D3201.6, R3201.2
/map_interno/MAPF: C3604.1, JP3601.1, R3601.2
/map_interno/VOUT: C3603.1, R3601.1, U3601.4
/mcu/5V_SENSOR_1_PG: R1006.1, U1004.4, U1501.43
/mcu/5V_SENSOR_2_PG: R1007.1, U1005.4, U1501.44
/mcu/12V_DIVIDED: C1523.1, D1501.1, R1503.2, R1504.1, U1501.53
/mcu/AT1: R25.1, R29.2, U1501.54
/mcu/AT2: R26.1, R30.2, U1501.55
/mcu/AT3: R27.1, R31.2, U1501.56
/mcu/AT4: R28.1, R32.2, U1501.57
/mcu/AUX_SPI_CS: J1505.2, U1501.24
/mcu/AUX_SPI_MISO: J1505.4, U1501.26
/mcu/AUX_SPI_MOSI: J1505.5, U1501.27
/mcu/AUX_SPI_SCK: J1505.3, U1501.25
/mcu/AV1: R1.1, R5.2, U1501.32
/mcu/AV2: R2.1, R6.2, U1501.33
/mcu/AV3: R3.1, R7.2, U1501.34
/mcu/AV4: R4.1, R8.2, U1501.35
/mcu/AV5: R9.1, R13.2, U1501.40
/mcu/AV6: R10.1, R14.2, U1501.41
/mcu/AV7: R11.1, R15.2, U1501.42
/mcu/AV8: R12.1, R16.2, U1501.47
/mcu/AV9: R17.1, R21.2, U1501.50
/mcu/AV10: R18.1, R22.2, U1501.51
/mcu/AV11: R19.1, R23.2, U1501.52
/mcu/BARO_SCL: R41.2, U9.2, U1501.79
/mcu/BARO_SDA: R39.2, U9.4, U1501.80
/mcu/BOOT0: R1513.1, SW1502.1, U1501.166
/mcu/CAN2_RX: U6.4, U1501.92
/mcu/CAN2_TX: U6.1, U1501.93
/mcu/CAN_RX: U904.4, U1501.142
/mcu/CAN_TX: U904.1, U1501.143
/mcu/DIGITAL1: U1202.6, U1501.115
/mcu/DIGITAL2: U1207.6, U1501.74
/mcu/DIGITAL3: U1207.4, U1501.75
/mcu/DIGITAL4: U1208.6, U1501.77
/mcu/DIGITAL5: U1202.4, U1501.76
/mcu/DIGITAL6: U1208.4, U1501.78
/mcu/LED1: D1504.2, U1501.2
/mcu/LED2: D1505.2, U1501.3
/mcu/LED3: D1506.2, U1501.4
/mcu/LED4: D1507.2, U1501.5
/mcu/SD_CS: J1.2, U1501.144
/mcu/SD_MISO: J1.7, U1501.140
/mcu/SD_MOSI: J1.3, U1501.141
/mcu/SD_SCK: J1.5, U1501.139
/mcu/SWCLK: J4.4, J1502.4, U1501.137
/mcu/SWDIO: J4.2, J1502.2, U1501.124
/mcu/UART_RX: J2.2, U1501.150
/mcu/UART_TX: J2.1, U1501.147
/mcu/U_PH0: C1521.1, U1501.29, Y1501.1
/mcu/U_PH1: C1522.1, U1501.30, Y1501.2
/mcu/U_VBAT: C30.1, D3.1, D4.1, U1501.6
/mcu/U_VCAP_1: C1518.1, U1501.81
/mcu/U_VCAP_2: C1519.1, U1501.125
/mcu/U_VREFP: C1520.1, U8.2, U1501.38
/mcu/VDDA: C1501.1, C1502.1, FB1501.2, U1501.39
/mcu/VR_1: R1215.2, R1220.1, U1203.7, U1501.68
/mcu/VR_2: R1216.2, U1204.7, U1501.69
/mcu/etb_1_DIR: U10.1, U1501.98
/mcu/etb_1_DIS: R1001.1, U10.11, U1501.99
/mcu/etb_1_PWM: U10.12, U1501.100
/mcu/etb_2_DIR: U11.1, U1501.97
/mcu/etb_2_DIS: R48.1, U11.11, U1501.96
/mcu/etb_2_PWM: U11.12, U1501.101
/mcu/highside_quad_IN1: RN1301.4, U1501.120
/mcu/highside_quad_IN2: RN1301.3, U1501.119
/mcu/highside_quad_IN3: RN1301.2, U1501.105
/mcu/highside_quad_IN4: RN1301.1, U1501.104
/mcu/ign1_IN1: RN1601.8, U1501.146, U1602.2
/mcu/ign1_IN2: RN1601.7, U1501.145, U1602.4
/mcu/ign1_IN3: RN1601.6, U1501.118, U1603.2
/mcu/ign1_IN4: RN1601.5, U1501.117, U1603.4
/mcu/ign2_IN1: RN1701.8, U1501.116, U1701.2
/mcu/ign2_IN2: RN1701.7, U1501.112, U1701.4
/mcu/ign2_IN3: RN1701.6, U1501.111, U1702.2
/mcu/ign2_IN4: RN1701.5, U1501.110, U1702.4
/mcu/ign3_IN1: RN1801.8, U1501.109, U1801.2
/mcu/ign3_IN2: RN1801.7, U1501.108, U1801.4
/mcu/ign3_IN3: RN1801.6, U1501.107, U1802.2
/mcu/ign3_IN4: RN1801.5, U1501.106, U1802.4
/mcu/lowside_quad1_IN1: RN201.4, RN202.8, U1501.151
/mcu/lowside_quad1_IN2: RN201.3, RN202.7, U1501.152
/mcu/lowside_quad1_IN3: RN201.2, RN202.6, U1501.153
/mcu/lowside_quad1_IN4: RN201.1, RN202.5, U1501.154
/mcu/lowside_quad2_IN1: RN301.4, RN302.8, U1501.155
/mcu/lowside_quad2_IN2: RN301.3, RN302.7, U1501.156
/mcu/lowside_quad2_IN3: RN301.2, RN302.6, U1501.157
/mcu/lowside_quad2_IN4: RN301.1, RN302.5, U1501.162
/mcu/lowside_quad3_IN1: RN401.4, RN402.8, U1501.163
/mcu/lowside_quad3_IN2: RN401.3, RN402.7, U1501.164
/mcu/lowside_quad3_IN3: RN401.2, RN402.6, U1501.165
/mcu/lowside_quad3_IN4: RN401.1, RN402.5, U1501.167
/mcu/lowside_quad4_IN1: RN501.4, RN502.8, U1501.168
/mcu/lowside_quad4_IN2: RN501.3, RN502.7, U1501.169
/mcu/lowside_quad4_IN3: RN501.2, RN502.6, U1501.170
/mcu/lowside_quad4_IN4: RN501.1, RN502.5, U1501.1
/mcu/nRESET: C1517.2, J4.3, J1502.10, R1502.1, SW1501.1, U1501.31
/pullup_hall1/GATE: Q3001.1, Q3002.3, R3001.2
/pullup_hall1/PU: Q3001.3, R3002.1
/pullup_hall2/GATE: Q3011.1, Q3012.3, R3011.2
/pullup_hall2/PU: Q3011.3, R3012.1
/pullup_hall3/GATE: Q3021.1, Q3022.3, R3021.2
/pullup_hall3/PU: Q3021.3, R3022.1
/quad_analog3/IN4: R904.1, RN901.4
/quad_analog3/OUT4: R20.1, R24.2
/usb_c/CC1: J3701.A5, R3701.1
/usb_c/CC2: J3701.B5, R3702.1
/vr3/INM: C3101.1, R3102.1, R3105.2, U3101.2
/vr3/INP: C3101.2, R3104.1, R3105.1, U3101.1
/vr3/N1: R3101.1, R3102.2
/vr3/N2: R3103.1, R3104.2
/wifi_rtc/3V3_WIFI: C4002.1, C4003.1, J4001.1, R4001.1, R4002.1, U4001.2, U4002.2
/wifi_rtc/ESP_EN: C4004.1, J4001.4, R4001.2, R4005.2, U4001.3
/wifi_rtc/ESP_IO0: J4001.5, R4002.2, R4006.2, U4001.27
/wifi_rtc/ESP_RXD: J4001.3, R4003.2, U4001.36
/wifi_rtc/ESP_TXD: J4001.2, R4004.1, U4001.37
AIN13: R2509.1, R2513.2, U1501.19
AIN14: R2510.1, R2514.2, U1501.28
GND: BT1.2, C1.2, C2.2, C3.2, C4.2, C5.2, C6.2, C7.2, C8.2, C9.2, C10.2, C11.2, C12.2, C13.2, C14.2, C15.2, C16.2, C17.2, C20.2, C21.1, C22.1, C25.1, C26.1, C27.1, C28.1, C29.2, C30.2, C701.2, C801.2, C901.2, C902.2, C903.2, C906.2, C1001.2, C1002.2, C1004.2, C1006.2, C1015.2, C1016.2, C1017.2, C1018.2, C1101.2, C1201.1, C1202.1, C1203.2, C1204.2, C1205.2, C1207.2, C1208.2, C1211.2, C1212.2, C1301.2, C1302.2, C1303.2, C1304.2, C1401.2, C1402.2, C1403.2, C1404.2, C1405.2, C1406.2, C1407.2, C1408.2, C1409.1, C1501.2, C1502.2, C1503.1, C1504.1, C1505.1, C1506.1, C1507.1, C1508.1, C1509.1, C1510.1, C1511.1, C1512.1, C1513.1, C1515.1, C1516.2, C1517.1, C1518.2, C1519.2, C1520.2, C1521.2, C1522.2, C1523.2, C1604.1, C1605.2, C1606.2, C1607.1, C1608.2, C1609.2, C1701.1, C1702.2, C1703.2, C1704.1, C1705.2, C1706.2, C1801.1, C1802.2, C1803.2, C1804.1, C1805.2, C1806.2, C1903.1, C2001.2, C2006.2, C2010.2, C2101.2, C2106.2, C2110.2, C2301.2, C2309.1, C2313.2, C2314.2, C2315.2, C2316.2, C2401.2, C2409.1, C2413.2, C2414.2, C2415.2, C2416.2, C2501.2, C2505.2, C2506.2, C2507.2, C2508.2, C2600.2, C2601.2, C2602.2, C2604.2, C2606.2, C2607.2, C2608.2, C2609.2, C2610.2, C2611.2, C2612.2, C2613.2, C2614.2, C2615.2, C2616.2, C2617.2, C2618.2, C2700.2, C2701.2, C2702.2, C2704.2, C2706.2, C2707.2, C2708.2, C2709.2, C2710.2, C2711.2, C2712.2, C2713.2, C2714.2, C2715.2, C2716.2, C2717.2, C2718.2, C3601.2, C3602.2, C3603.2, C3604.2, C4001.2, C4002.2, C4003.2, C4004.2, C4005.2, C4006.2, C4007.2, C4008.2, C4009.2, D1.3, D2.3, D901.2, D1001.2, D1501.2, D2600.1 (K), D2603.1 (K), D2604.3 (S), D2700.1 (K), D2703.1 (K), D2704.3 (S), D3201.1, D3201.2, D3201.3, H1.1, H2.1, H3.1, H4.1, J1.6, J1.9, J4.5, J101.33, J101.34, J102.26, J102.27, J103.3, J103.4, J105.1, J1502.3, J1502.5, J1502.9, J1505.6, J2600.5, J2700.5, J3701.A1, J3701.A12, J3701.B1, J3701.B12, J4001.6, JP1201.3, M1.G (GND), M1.J_GND1 (PULL_DOWN1), M1.J_GND2 (PULL_DOWN2), M2.G (GND), M2.J_GND1 (PULL_DOWN1), M2.J_GND2 (PULL_DOWN2), Q2600.3 (S), Q2700.3 (S), Q3002.2, Q3012.2, Q3022.2, R5.1, R6.1, R7.1, R8.1, R13.1, R14.1, R15.1, R16.1, R21.1, R22.1, R23.1, R24.1, R29.1, R30.1, R31.1, R32.1, R34.2, R35.2, R36.2, R37.2, R38.2, R701.2, R702.2, R703.2, R704.2, R801.2, R802.2, R803.2, R804.2, R901.2, R902.2, R903.2, R904.2, R905.2, R907.2, R1106.2, R1108.2, R1110.2, R1112.2, R1218.1, R1501.2, R1504.2, R1508.1, R1509.1, R1510.1, R1511.1, R1512.1, R1513.2, R2329.1, R2330.1, R2331.1, R2332.1, R2429.1, R2430.1, R2431.1, R2432.1, R2501.2, R2502.2, R2503.2, R2504.2, R2513.1, R2514.1, R2515.1, R2516.1, R2601.2, R2617.1, R2620.2, R2625.1, R2626.1, R2627.1, R2701.2, R2717.1, R2720.2, R2725.1, R2726.1, R2727.1, R3003.2, R3013.2, R3023.2, R3701.2, R3702.2, RN202.1, RN202.2, RN202.3, RN202.4, RN302.1, RN302.2, RN302.3, RN302.4, RN402.1, RN402.2, RN402.3, RN402.4, RN502.1, RN502.2, RN502.3, RN502.4, RN1601.1, RN1601.2, RN1601.3, RN1601.4, RN1701.1, RN1701.2, RN1701.3, RN1701.4, RN1801.1, RN1801.2, RN1801.3, RN1801.4, RN2202.1, RN2202.2, RN2202.3, RN2202.4, SW1501.2, U1.2, U2.2, U3.2, U4.2, U5.11, U6.2, U6.8, U7.4, U8.3, U9.3, U9.5, U9.8, U9.9, U10.6, U10.13, U11.6, U11.13, U201.5, U201.7, U202.5, U202.7, U301.5, U301.7, U302.5, U302.7, U401.5, U401.7, U402.5, U402.7, U501.5, U501.7, U502.5, U502.7, U701.11, U801.11, U901.11, U902.1, U903.7, U903.9, U904.2, U904.8, U1004.3, U1004.9, U1005.3, U1005.9, U1101.11, U1106.2, U1107.2, U1202.2, U1203.5, U1204.4, U1204.5, U1204.6, U1204.9, U1207.2, U1208.2, U1501.14, U1501.22, U1501.37, U1501.48, U1501.58, U1501.61, U1501.71, U1501.90, U1501.102, U1501.113, U1501.126, U1501.135, U1501.148, U1501.158, U1502.2, U1602.3, U1603.3, U1701.3, U1702.3, U1801.3, U1802.3, U2201.5, U2201.7, U2202.5, U2202.7, U2301.11, U2304.2, U2401.11, U2404.2, U2501.11, U2502.2, U2600.11 (V-), U2601.2 (V-), U2602.2 (PF0), U2602.3 (PF1), U2602.16 (VSS), U2602.32 (VSSA), U2603.3 (GND), U2604.1 (GND), U2605.2 (GND), U2605.8 (S), U2700.11 (V-), U2701.2 (V-), U2702.2 (PF0), U2702.3 (PF1), U2702.16 (VSS), U2702.32 (VSSA), U2703.3 (GND), U2704.1 (GND), U2705.2 (GND), U2705.8 (S), U3101.4, U3101.5, U3101.6, U3101.9, U3601.3, U4001.1, U4001.40, U4001.41, U4002.1
HALL_PU1: Q3002.1, R3003.1, U1501.66
HALL_PU2: Q3012.1, R3013.1, U1501.67
HALL_PU3: Q3022.1, R3023.1, U1501.160
LED_B: R3203.1, U1501.8
LED_G: R3202.1, U1501.65
LED_R: R3201.1, U1501.64
LS17_IN: RN2201.4, RN2202.8, U1501.70
LS18_IN: RN2201.3, RN2202.7, U1501.73
LS19_IN: RN2201.2, RN2202.6, U1501.94
LS20_IN: RN2201.1, RN2202.5, U1501.95
LSE_IN: C4005.1, U1501.9, Y4001.1
LSE_OUT: C4006.1, U1501.10, Y4001.2
unnamed: BT1.1, D3.2
unnamed: C21.2, R42.1, R44.2
unnamed: C22.2, R43.1, R45.2
unnamed: C23.1, R44.1, R46.2
unnamed: C24.1, R45.1, R47.2
unnamed: C1006.1, R906.2
unnamed: C1901.1, JP1.2, R1901.2
unnamed: C1902.1, JP2.2, R1902.2
unnamed: C904.2, D901.1, L1001.1, U903.8
unnamed: D1502.1, R1508.2
unnamed: D1504.1, R1509.2
unnamed: D1505.1, R1510.2
unnamed: D1506.1, R1511.2
unnamed: D1507.1, R1512.2
unnamed: JP1201.2, U1203.6
unnamed: R1205.1, R1206.2
unnamed: R1208.1, R1209.2
unnamed: R1210.1, R1211.2
unnamed: R1213.1, R1214.2
unnamed: R42.2, R1903.1, U5.1
unnamed: R43.2, R1904.1, U5.14
unnamed: RN201.8, U202.3
unnamed: RN201.7, U202.1
unnamed: RN201.6, U201.3
unnamed: RN201.5, U201.1
unnamed: RN301.8, U302.3
unnamed: RN301.7, U302.1
unnamed: RN301.6, U301.3
unnamed: RN301.5, U301.1
unnamed: RN401.8, U402.3
unnamed: RN401.7, U402.1
unnamed: RN401.6, U401.3
unnamed: RN401.5, U401.1
unnamed: RN501.8, U502.3
unnamed: RN501.7, U502.1
unnamed: RN501.6, U501.3
unnamed: RN501.5, U501.1
unnamed: C1.1, RN701.8, U1.6, U701.3
unnamed: C2.1, RN701.7, U1.1, U701.5
unnamed: C3.1, RN701.6, U1.3, U701.10
unnamed: C4.1, RN701.5, U1.4, U701.12
unnamed: C5.1, RN801.8, U2.6, U801.3
unnamed: C6.1, RN801.7, U2.1, U801.5
unnamed: C7.1, RN801.6, U2.3, U801.10
unnamed: C8.1, RN801.5, U2.4, U801.12
unnamed: C9.1, RN901.8, U3.6, U901.3
unnamed: C10.1, RN901.7, U3.1, U901.5
unnamed: C11.1, RN901.6, U3.3, U901.10
unnamed: C12.1, RN901.5, U3.4, U901.12
unnamed: C13.1, RN1101.8, U4.6, U1101.3
unnamed: C14.1, RN1101.7, U4.1, U1101.5
unnamed: C15.1, RN1101.6, U4.3, U1101.10
unnamed: C16.1, RN1101.5, U4.4, U1101.12
unnamed: RN1301.8, U1105.2
unnamed: RN1301.7, U1104.2
unnamed: RN1301.6, U1103.2
unnamed: RN1301.5, U1102.2
unnamed: RN2201.8, U2202.3
unnamed: RN2201.7, U2202.1
unnamed: RN2201.6, U2201.3
unnamed: RN2201.5, U2201.1
unnamed: C2313.1, RN2301.8, U2301.3, U2304.6
unnamed: C2314.1, RN2301.7, U2301.5, U2304.1
unnamed: C2315.1, RN2301.6, U2301.10, U2304.3
unnamed: C2316.1, RN2301.5, U2301.12, U2304.4
unnamed: C2413.1, RN2401.8, U2401.3, U2404.6
unnamed: C2414.1, RN2401.7, U2401.5, U2404.1
unnamed: C2415.1, RN2401.6, U2401.10, U2404.3
unnamed: C2416.1, RN2401.5, U2401.12, U2404.4
unnamed: C2505.1, RN2501.8, U2501.3, U2502.6
unnamed: C2506.1, RN2501.7, U2501.5, U2502.1
unnamed: C2507.1, RN2501.6, U2501.10, U2502.3
unnamed: C2508.1, RN2501.5, U2501.12, U2502.4
unnamed: R1901.1, R1903.2, U5.2
unnamed: C25.2, R46.1, U5.5
unnamed: C26.2, R47.1, U5.10
unnamed: R1902.1, R1904.2, U5.13
unnamed: U7.1, U7.2
unnamed: U7.6, U7.7
unnamed: R1.2, U701.1, U701.2
unnamed: R2.2, U701.6, U701.7
unnamed: R3.2, U701.8, U701.9
unnamed: R4.2, U701.13, U701.14
unnamed: R9.2, U801.1, U801.2
unnamed: R10.2, U801.6, U801.7
unnamed: R11.2, U801.8, U801.9
unnamed: R12.2, U801.13, U801.14
unnamed: R17.2, U901.1, U901.2
unnamed: R18.2, U901.6, U901.7
unnamed: R19.2, U901.8, U901.9
unnamed: R20.2, U901.13, U901.14
unnamed: C904.1, U903.1
unnamed: C1001.1, C1002.1, L1002.2, U903.2, U903.3
unnamed: C905.2, R907.1, R908.1, U903.5
unnamed: R905.1, U903.4
unnamed: C902.1, U903.6
unnamed: R25.2, U1101.1, U1101.2
unnamed: R26.2, U1101.6, U1101.7
unnamed: R27.2, U1101.8, U1101.9
unnamed: R28.2, U1101.13, U1101.14
unnamed: R1106.1, U1102.1
unnamed: R1105.1, U1102.4
unnamed: R1108.1, U1103.1
unnamed: R1107.1, U1103.4
unnamed: R1110.1, U1104.1
unnamed: R1109.1, U1104.4
unnamed: R1112.1, U1105.1
unnamed: R1111.1, U1105.4
unnamed: C1205.1, R1202.1, U1106.1, U1202.3
unnamed: C1402.1, R1402.1, U1106.3, U1202.1
unnamed: C1404.1, R1404.1, U1106.4, U1207.1
unnamed: C1406.1, R1406.1, U1106.6, U1207.3
unnamed: C1408.1, R1408.1, U1107.1, U1107.6, U1208.1
unnamed: C1208.1, R1204.1, U1107.3, U1107.4, U1208.3
unnamed: C1212.1, R1217.2, R1218.2, R1219.2, U1203.4
unnamed: R1219.1, R1220.2, U1203.8
unnamed: C1209.2, R1207.1, R1209.1, U1203.1
unnamed: C1209.1, R1206.1, R1207.2, U1203.2
unnamed: C1210.2, R1212.1, R1214.1, U1204.1
unnamed: C1210.1, R1211.1, R1212.2, U1204.2
unnamed: R1601.2, U1602.7
unnamed: R1602.2, U1602.5
unnamed: R1603.2, U1603.7
unnamed: R1604.2, U1603.5
unnamed: R1701.2, U1701.7
unnamed: R1702.2, U1701.5
unnamed: R1703.2, U1702.7
unnamed: R1704.2, U1702.5
unnamed: R1801.2, U1801.7
unnamed: R1802.2, U1801.5
unnamed: R1803.2, U1802.7
unnamed: R1804.2, U1802.5
unnamed: R2325.2, U2301.1, U2301.2
unnamed: R2326.2, U2301.6, U2301.7
unnamed: R2327.2, U2301.8, U2301.9
unnamed: R2328.2, U2301.13, U2301.14
unnamed: R2425.2, U2401.1, U2401.2
unnamed: R2426.2, U2401.6, U2401.7
unnamed: R2427.2, U2401.8, U2401.9
unnamed: R2428.2, U2401.13, U2401.14
unnamed: R2509.2, U2501.1, U2501.2
unnamed: R2510.2, U2501.6, U2501.7
unnamed: R2511.2, U2501.8, U2501.9
unnamed: R2512.2, U2501.13, U2501.14
SW1: R2325.1, R2329.2, U1501.16
SW2: R2326.1, R2330.2, U1501.17
SW3: R2327.1, R2331.2, U1501.18
SW4: R2328.1, R2332.2, U1501.59
SW5: R2425.1, R2429.2, U1501.60
SW6: R2426.1, R2430.2, U1501.63
SW7: R2427.1, R2431.2, U1501.138
SW8: R2428.1, R2432.2, U1501.161
USB_DM: J3701.A7, J3701.B7, U1501.122, U1502.3, U1502.4
USB_DP: J3701.A6, J3701.B6, U1501.123, U1502.1, U1502.6
USB_SHLD: C1516.1, J3701.S1, R1501.1
USB_VBUS: D1503.2, J3701.A4, J3701.A9, J3701.B4, J3701.B9, U1502.5
VR3_OUT: R3106.2, U1501.121, U3101.7
WIFI_BOOT: R4006.1, U1501.174
WIFI_EN: R4005.1, U1501.173
WIFI_RX: R4004.2, U1501.129
WIFI_TX: R4003.1, U1501.128
