CarlosCiconato/ecu-master/(commit log)

2026-11-10 ECU master: firmware (patches e placa), placa top 6c e notas
    [Log V8 biturbo - puxada de teste.csv, Pin FMEA.xlsx, base.stl, bom-jlc-top6c-r7.csv, caixa.step, etb-9201.kicad_sch, hall_pullup.kicad_sch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]
2026-11-12 Separa a placa do programa: o programa fica no ecu-app
    [Log V8 biturbo - puxada de teste.csv]
